babssouza/designFlow_RFmodeling/README.md

# HW designFlow Methods - RF Models and Measurements
Brief descriptions of the HW designFlow RFmodeling versions:
- V1I1: #1 implementation validating the in-fixture SOLT and TRL calibration, embed/de-embed measured models aiming loadPull data (S2-LP, SX1262 and BlueNRG) and touchstone files model (SKY66420)
