babssouza/designFlow_RFmodeling/V1I1/Design Files/readme.txt

---------------------------------------------------------------------------------------------------------------------
Cadence Design Files
---------------------------------------------------------------------------------------------------------------------        
        - Artwork/ Gerbers and drill files
        - Board Assembly/ assembly reference gerbers
        - Layout/ .mcm or .brd files
        - Netlist/
        - ODB/
        .DBK .opj .DSN files: schematic design

---------------------------------------------------------------------------------------------------------------------
