babssouza/designFlow_RFmodeling/V1I1/! Docs/Report - Design - RF Modeling.docx

HT MICRON SEMICONDUTORES S.A. Av. Unisinos, 1550 | 93022-750 | São Leopoldo | RS | Brasil www.htmicron.com.br | HT MICRON

This document in a property of HT Micron and cannot be reproduced without its consent.

HT Micron does not assume any responsibility for use what is described.

This document is subject to change without notice.

RF Design Flow –Measurements for Model Generation

HT Micron Semiconductors – Advanced Technology R&D
Classification: | HW TEAM
Doc. Type: | DESIGN REPORT
Revision: | Rev. 0
Date: | 22/08/2020
Code: | DF-RFM

# Summary

# 1 DOCUMENT INFO

This document objective is present the SKY66420 RF FEM transmitter path design process. The critical point is design the power amplifier matching network to achieve the transmitter expected performance. The amplifier need work with:

- Operation frequency range: 868MHz to 928MHz
- Constant Gain: 16dB
- Desired output power: 22dBm
- Input Power: 6dBm
- Current consumption around 150mA

The expected current consumption is based on this datasheet curve:

In the future we can optimize the amplifier’s efficiency adjusting the V_(CC) value to a smaller value.

Considering the Gain trade-off for the lower V_(CC) voltage.

The reference network suggested by the SKYWORKS is implemented in the reference design kit. The schematics is presented here.

# 2 Test fixture - STANDARD design

This test fixture is designed to operate in the frequency range of 375MHz to 3GHz. Using the RO4003C laminate with cooper of 35um and core height of 813um.

## 2.1 Proposed Structure

As starting point we use a coplanar waveguide (cpw) calculator (http://wcalc.sourceforge.net/cgi-bin/coplanar.cgi) to define the structure parameters and go to an interactive approach into the layout and simulation, where the length of the CPW was estimated considering an wavelength calculator (https://www.microwaves101.com/calculators/873-wavelength-calculator ) too.

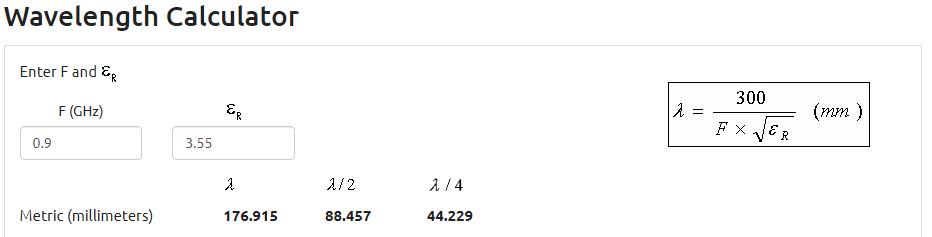
[picture p1: figure]
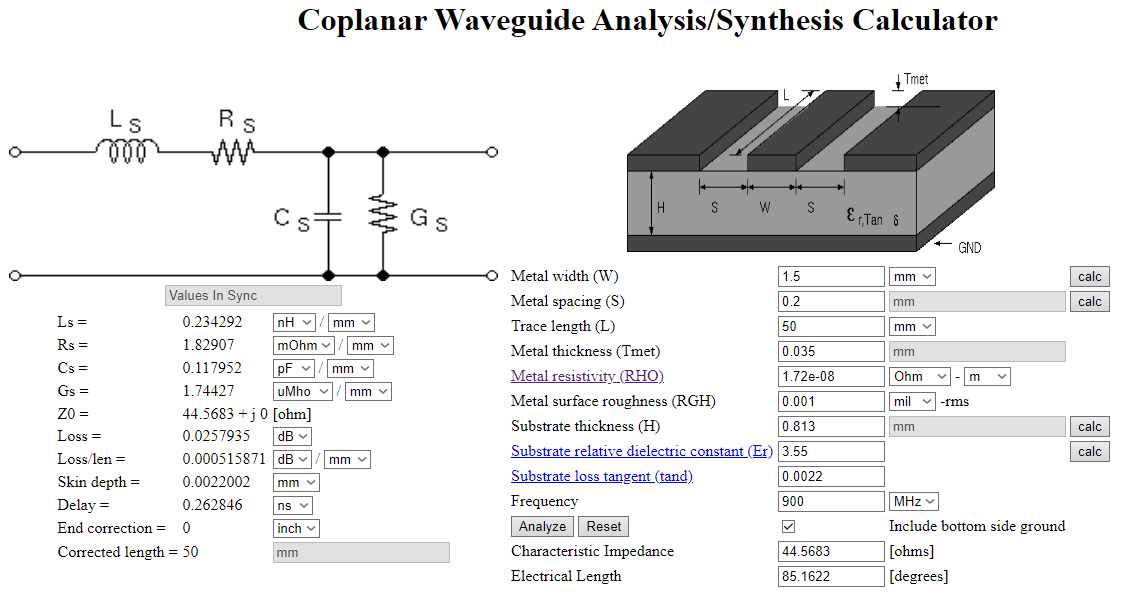
[picture p2: figure]
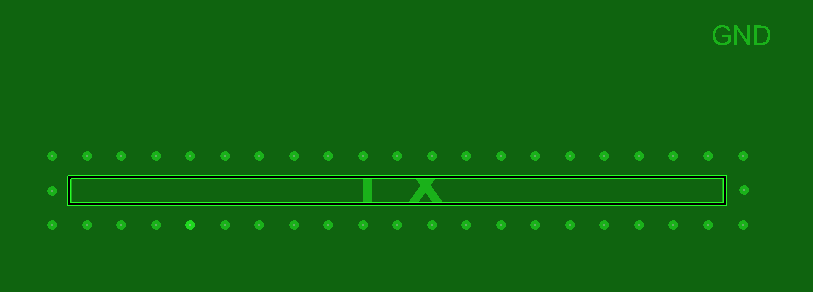
[picture p3: figure]

And the partial results

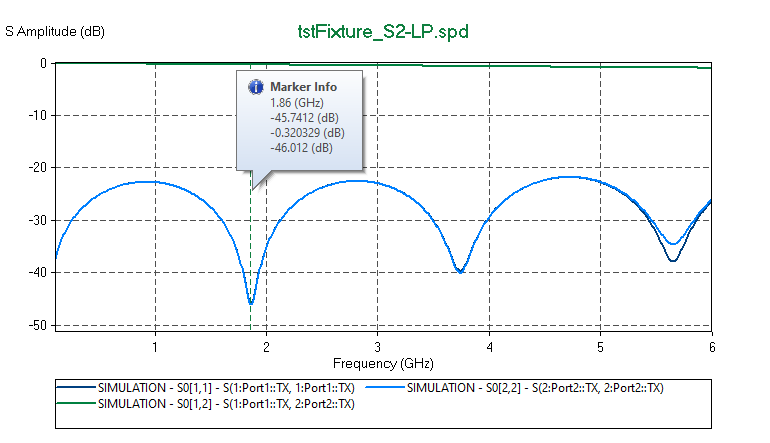
[picture p4: figure]

## 2.2 Test Fixture Design

### 2.2.1 Characteristic Impedance Variations

The transmission line width (W=1.65) and the metal spacing (S) varies during the manufacturing process within a 20 % tolerance, then 1.32mm and 1.98mm are expected values for W while 0.16mm and 0.24mm are expected values for S. The length of the transmission line will be affected too: The worst-case analysis shows the following scenarios:

- Higher impedance: W=1.32mm; S=0.24mm
- Lower Impedance: W=1.98mm; S=0.16mm
- Intermediate 1: W=1.98mm, S=0.24mm
- Intermediate 2: W=1.32mm, S=0.16mm

### 2.2.2 Via Stitching and shielding

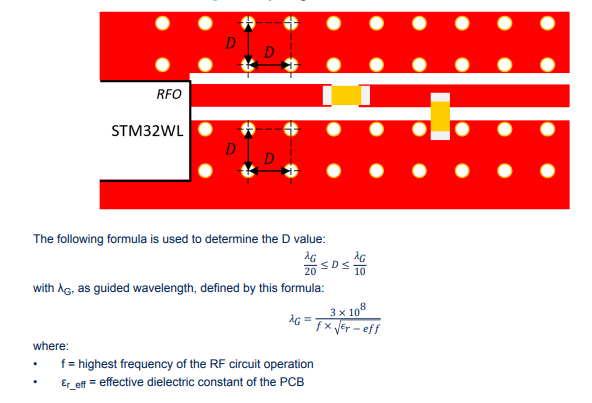
[picture p5: figure]

Considering the 9th harmonic from a 3GHz carrier: the higher circuit frequency is 27GHz. Where the effective dielectric constant for W/H<1 is 2.76. (https://www.pasternack.com/t-calculator-microstrip.aspx ):

D must be a value between 0.65mm and 1.2mm. We choose spacing of 1.1mm with a cline (from transmission line) offset of 0.8mm.

### 2.2.3 Layout and Simulations

The final version has the length of 35mm.

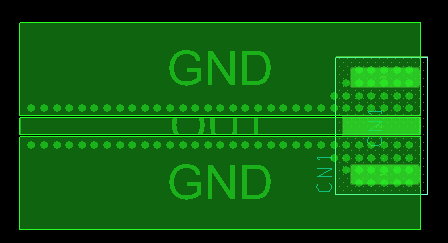
[picture p6: figure]
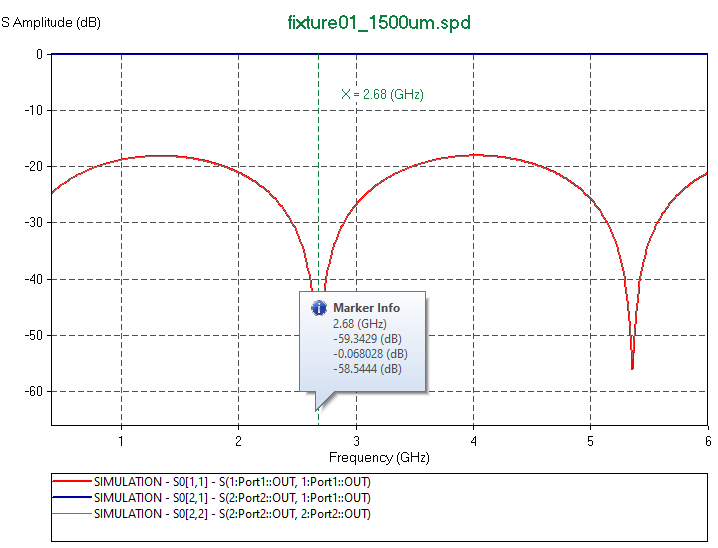
[picture p7: figure]

### 2.2.4 Worst Case – Process Variations

Note that all the process variations contribute to lower the resonant frequency.

## 2.3 Emded/De-Embed Model

Z_(IN) =18.3-j28.6 @ 900MHz

# 3 Calibration kits design

In this approach we will design a new matching network based in four steps:

## 3.1 TRL Calibration

The choke inductor (L) reactance need to be at least 10 times the value of port impedance, in other words: 80 ohms, the choke inductance value will be:

X_(CHOKE) = ωL=2πfL= 2π(900MHz)(15nH)=85Ω

Doing this, the choke impedance will not be counted in the network design, as long as its minimum value is greater than 15nH. The network was re-designed in the smith-chart, just adjusting the capacitors values:

For this new ideal network, Z_(IN) =48+j2≡48Ω

## 3.2 SOLT Calibration

Note that the system performance will not be degraded

# 4 Test Fixture Design

## 4.1 SKYWORKS – SKY66420

## 4.2 ST Microelectronics S2-LP die

## 4.3 SEMTECH SX1262 die

## 4.4 ST Microelectronics BluNRG LP

# 5 CONCLUSIONS

# ABBREVIATIONS

Table 10: Abbreviations

Acronym | Description
ADC | Analog to Digital Converter
AES | Advanced Encryption Standard
API | Application Program Interface
CLK | Clock
EEPROM | Electrically-Erasable Programmable Read Only Memory
FIFO | First in First Out
GPIO | General Purpose Input Output
ID | Identification
IF | Intermediate frequency
IO | Input Output
MSL | Moisture sensitivity level
PCB | Printed-Circuit Board
PHY | Physical
SPI-bus | Serial Peripheral Interface -bus
PWM | Pulse Width Modulation
RAM | Random Access Memory
RC | Remote Control
RF | Radio Frequency
RoHS | Restriction of Hazardous Substances
RSSI | Receive Signal Strength Indication
RX | Receiver
SCL | Serial Clock
SDA | Serial Data
TX | Transmitter

# LIST OF FIGURES

# LIST OF TABLES

# REVISION HISTORY

Date | Version | Changes | Authors
01/11/2019 | 00 | - Initial draft | WH
19/11/2019 | 01 | - Initial release | FK
12/12/2019 | 02 | - Review template | SG
29/01/2020 | 03 | - Review styles | WH

# CONTACT

HT MICRON SEMICONDUTORES S.A.

Av. Unisinos, 1550 | 93022-750 | São Leopoldo | RS | Brasil

github.com/htmicron/ht32sx

support_iot@htmicron.com.br

www.htmicron.com.br

# DOCUMENT INFORMATION

Document Title: RF Design Flow –Measurements for Model Generation

Document Subtitle: HT Micron Semiconductors – Advanced Technology R&D

Classification: HW TEAM

Doc. Type: DESIGN REPORT

Revision: Rev. 0

Date: 22/08/2020

Code: DF-RFM

HT MICRON HW TEAM 1/18

RF Design Flow –Measurements for Model Generation DF-RFM – Rev. 0
