babssouza/designFlow_RFmodeling/V1I1/! Docs/readme.txt

---------------------------------------------------------------------------------------------------------------------
IMPORTANT DOCUMENTATION:
---------------------------------------------------------------------------------------------------------------------        
        - Requirements
                - Product Requirements:     functionalities, size, etc...
                - Project Requirements:     deadlines, resources, manufacture and assembly sugestions
        - Benchmark analysis
        - Ongoing Design Reports
        - General design/measurement plans
        - Design calculations tools (justification word docs, excel calcs, octave scrpits, etc)
        - Simulation reports
        - Measured performance reports
        - Final design Report
        
---------------------------------------------------------------------------------------------------------------------
