babssouza/designFlow_RFmodeling/V1I1/Design Output Files/PCB MAnufacturing/BME-XX - Board (PCB) Manufacture Especifications.xlsx

PCB Quotation Request
Source Data From: |  | Revision Date: | Contact Info:
Project: |  | Author: | 0
Project Revision: |  | Obs.: | #N/A
 |  |  | Phone: +55 51 980451100
Specifications | Complementary Details
PCB Name:
Material:
Size
Quantity:
Layers:
Sides with Components:
TG (°C):
Thickness (mm):
Min Track/Spacing (mil):
Min Hole Size:
Solder Mask:
Solder Mask Height Control:
Silkscreen:
Surface Finish:
Via Type:
Blind Vias:
Buried Vias:
Via Anular Size:
BGA:
Finished Cooper:
Other Specifications / Observations:
