babssouza/designFlow_RFmodeling/V1I1/Measurements/read_me.txt

Create a directory for each measurement setup: save the data files and the equipment configuration.
Copy the measurment plan here too.
