babssouza/designFlow_RFmodeling/(list of files, drawings)

Other design files:
V1I1/Design Files/TESTFIXTURE_SKY66420.DSN
V1I1/Design Files/testFixture_SKY66420.opj
V1I1/Design Files/TSTFIXTURE_CALSOLT.DSN
V1I1/Design Files/tstfixture_calsolt.opj
V1I1/Design Files/TSTFIXTURE_CALTRL.DSN
V1I1/Design Files/tstFixture_calTRL.opj
V1I1/Design Files/TSTFIXTURE_S2-LP.DSN
V1I1/Design Files/tstFixture_S2-LP.opj
V1I1/Design Files/TSTFX_S2-LP.DSN
V1I1/Design Files/tstfx_s2-lp.opj
