babssouza/designFlow_RFmodeling/(commit log)

2020-08-12 initial release
    [BME-XX - Board (PCB) Manufacture Especifications.xlsx]
2020-08-20 add the documentation and starting design
    [MW101-TRLCalc-rev1.xlsx, TSTFIXTURE_S2-LP.DSN, tstFixture_S2-LP.opj]
2020-08-27 Fixture Standard, TRL and SOLT calibration kit done
    [MW101-TRLCalc-rev1.xlsx, TSTFIXTURE_CALSOLT.DSN, TSTFIXTURE_CALTRL.DSN, TSTFIXTURE_S2-LP.DSN, tstFixture_S2-LP.opj, tstFixture_calTRL.opj, tstfixture_calsolt.opj]
2020-08-30 S2-LP Test Fixture - wire bonding modeling tstfx - Lines for TRL cal kit 1-8GHz and 3-24GHz - SKY66420 tstfx
    [TESTFIXTURE_SKY66420.DSN, TSTFIXTURE_S2-LP.DSN, TSTFX_S2-LP.DSN, testFixture_SKY66420.opj, tstFixture_S2-LP.opj, tstfx_s2-lp.opj]
